bitsy-ai/printnanny-sdwire/README.md

# printnanny-sdwire
A modified version of Tizen SDWire https://wiki.tizen.org/SDWire
