bitsy-ai/printnanny-sdwire/board/exports/SDWire-v1.4-r1/README.txt

PCB Thickness: 0.8mm
Surface Finish: ENIG-RoHS

File descriptions:

SDWire-v1.4-r1.GTP Top Solder Paste
SDWire-v1.4-r1.GTO Top Silkscreen
SDWire-v1.4-r1.GTS Top Solder Mask
SDWire-v1.4-r1.GTL Top Copper
SDWire-v1.4-r1.G2L Inner 2 Copper (closest to Top)
SDWire-v1.4-r1.G3L Inner 3 Copper (closest to Bottom)
SDWire-v1.4-r1.GBL Bottom Copper
SDWire-v1.4-r1.GBS Bottom Solder Mask
SDWire-v1.4-r1.GBO Bottom Silkscreen
SDWire-v1.4-r1.GBP Bottom Solder Paste

SDWire-v1.4-r1.GKO Board outline
SDWire-v1.4-r1-NPTH.XLN Non-plated drills
SDWire-v1.4-r1-PTH.XLN Plated drills
