bitsy-ai/printnanny-sdwire/board/SDWire.kicad_pcb

## KiCad design board/SDWire.kicad_pcb (2022-09-02)

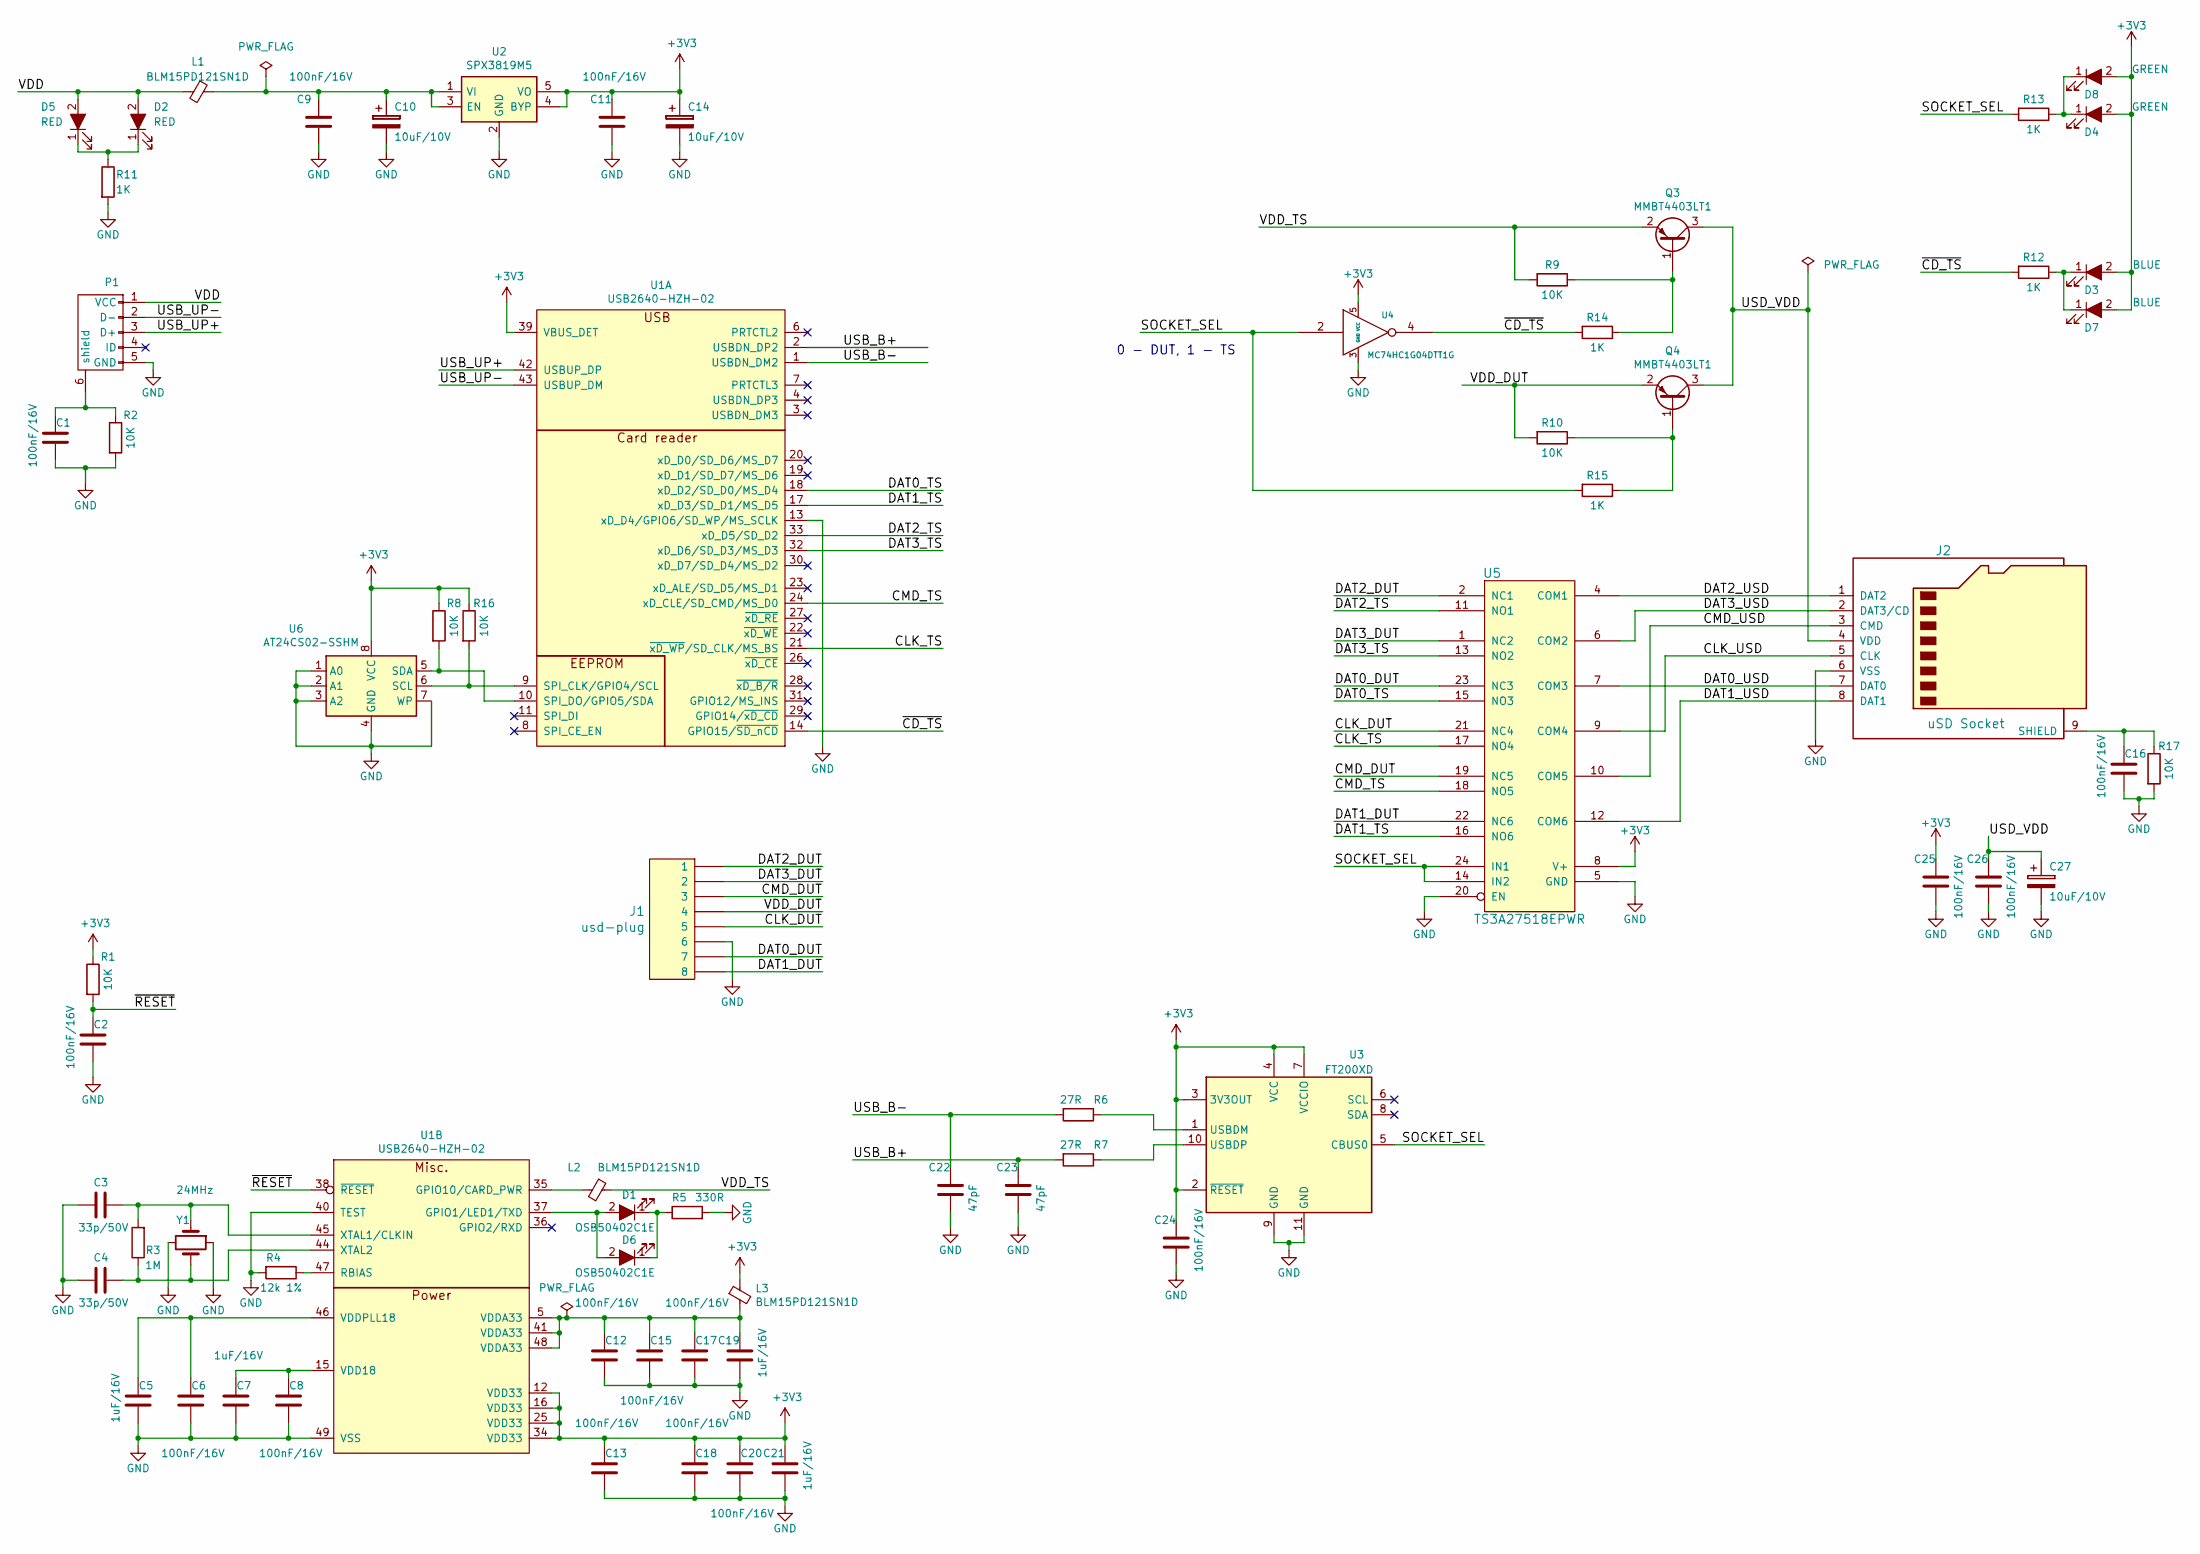
[picture p1: schematic SDWire.kicad_sch, PrintNanny SDWire]

Parts:
C1, C2, C6, C8, C9, C11, C12, C13, C15, C16, C17, C18, C20, C24, C25, C26: 100nF/16V; C_0402_1005Metric
C3, C4: 33p/50V; C_0402_1005Metric
C5, C7, C19, C21: 1uF/16V; C_0402_1005Metric
C10, C14, C27: 10uF/10V; CP_EIA-3216-18_Kemet-A_Pad1.58x1.35mm_HandSolder
C22, C23: 47pF; C_0402_1005Metric
D1, D6: OSB50402C1E; LED_0402_1005Metric
D2, D5: RED; LED_0402_1005Metric
D3, D7: BLUE; LED_0402_1005Metric
D4, D8: GREEN; LED_0402_1005Metric
J1: usd-plug; usd
J2: uSD Socket; microSD_HC_Molex_104031-0811
L1, L2, L3: BLM15PD121SN1D; L_0402_1005Metric
P1: USB_OTG_MICRO_USB; USB_Micro-B_Molex-105017-0001
Q3, Q4: MMBT4403LT1; SOT-23
R1, R2, R8, R9, R10, R16, R17: 10K; R_0402_1005Metric
R3: 1M; R_0402_1005Metric
R4: 12k 1%; R_0402_1005Metric
R5: 330R; R_0402_1005Metric
R6, R7: 27R; R_0402_1005Metric
R11, R12, R13, R14, R15: 1K; R_0402_1005Metric
U1: USB2640-HZH-02; QFN-48-1EP_7x7mm_Pitch0.5mm
U2: SPX3819M5; SOT-23-5
U3: FT200XD; DFN-10-1EP_3x3mm_P0.5mm_EP1.55x2.48mm
U4: MC74HC1G04DTT1G; SOT-23-5_HandSoldering
U5: TS3A27518EPWR; TSSOP-24
U6: AT24CS02-SSHM; SOIC-8_3.9x4.9mm_P1.27mm
Y1: 24MHz; Crystal_SMD_2520-4pin_2.5x2.0mm

Connections:
+3V3: C11.1, C13.1, C14.1, C18.1, C20.1, C21.1, C24.1, C25.1, D3.2 (A), D4.2 (A), D7.2 (A), D8.2 (A), L3.1, R1.1, R8.1, R16.1, U1.12 (VDD33), U1.16 (VDD33), U1.25 (VDD33), U1.34 (VDD33), U1.39 (VBUS_DET), U2.4 (BYP), U2.5 (VO), U3.2 (~RESET), U3.3 (3V3OUT), U3.4 (VCC), U3.7 (VCCIO), U4.5 (VCC), U5.8 (V+), U6.8 (VCC)
/CLK_DUT: J1.5, U5.21 (NC4)
/CLK_TS: U1.21 (~xD_WP/SD_CLK/MS_BS), U5.17 (NO4)
/CLK_USD: J2.5 (CLK), U5.9 (COM4)
/CMD_DUT: J1.3, U5.19 (NC5)
/CMD_TS: U1.24 (xD_CLE/SD_CMD/MS_D0), U5.18 (NO5)
/CMD_USD: J2.3 (CMD), U5.10 (COM5)
/DAT0_DUT: J1.7, U5.23 (NC3)
/DAT0_TS: U1.18 (xD_D2/SD_D0/MS_D4), U5.15 (NO3)
/DAT0_USD: J2.7 (DAT0), U5.7 (COM3)
/DAT1_DUT: J1.8, U5.22 (NC6)
/DAT1_TS: U1.17 (xD_D3/SD_D1/MS_D5), U5.16 (NO6)
/DAT1_USD: J2.8 (DAT1), U5.12 (COM6)
/DAT2_DUT: J1.1, U5.2 (NC1)
/DAT2_TS: U1.33 (xD_D5/SD_D2), U5.11 (NO1)
/DAT2_USD: J2.1 (DAT2), U5.4 (COM1)
/DAT3_DUT: J1.2, U5.1 (NC2)
/DAT3_TS: U1.32 (xD_D6/SD_D3/MS_D3), U5.13 (NO2)
/DAT3_USD: J2.2 (DAT3/CD), U5.6 (COM2)
/SOCKET_SEL: R13.2, R15.2, U3.5 (CBUS0), U4.2, U5.14 (IN2), U5.24 (IN1)
/USB_B+: C23.1, R7.2, U1.2 (USBDN_DP2)
/USB_B-: C22.1, R6.2, U1.1 (USBDN_DM2)
/USB_UP+: P1.3 (D+), U1.42 (USBUP_DP)
/USB_UP-: P1.2 (D-), U1.43 (USBUP_DM)
/USD_VDD: C26.1, C27.1, J2.4 (VDD), Q3.3 (C), Q4.3 (C)
/VDD: D2.2 (A), D5.2 (A), L1.2, P1.1 (VCC)
/VDD_DUT: J1.4, Q4.2 (E), R10.2
/VDD_TS: L2.1, Q3.2 (E), R9.2
/~CD_TS: R12.2, R14.2, U1.14 (GPIO15/~SD_nCD), U4.4
/~RESET: C2.1, R1.2, U1.38 (~RESET)
GND: C1.2, C2.2, C3.2, C4.2, C5.2, C6.2, C7.2, C8.2, C9.2, C10.2, C11.2, C12.2, C13.2, C14.2, C15.2, C16.2, C17.2, C18.2, C19.2, C20.2, C21.2, C22.2, C23.2, C24.2, C25.2, C26.2, C27.2, J1.6, J2.6 (VSS), P1.5 (GND), R2.2, R4.2, R5.2, R11.2, R17.2, U1.13 (xD_D4/GPIO6/SD_WP/MS_SCLK), U1.40 (TEST), U1.49 (VSS), U2.2 (GND), U3.9 (GND), U3.11 (GND), U4.3 (GND), U5.5 (GND), U5.20 (EN), U6.1 (A0), U6.2 (A1), U6.3 (A2), U6.4 (GND), U6.7 (WP), Y1.2, Y1.4
unnamed: C1.1, P1.6 (shield), R2.1
unnamed: C3.1, R3.2, U1.45 (XTAL1/CLKIN), Y1.1
unnamed: C4.1, R3.1, U1.44 (XTAL2), Y1.3
unnamed: C5.1, C6.1, U1.46 (VDDPLL18)
unnamed: C7.1, C8.1, U1.15 (VDD18)
unnamed: C9.1, C10.1, L1.1, U2.1 (VI), U2.3 (EN)
unnamed: C12.1, C15.1, C17.1, C19.1, L3.2, U1.5 (VDDA33), U1.41 (VDDA33), U1.48 (VDDA33)
unnamed: C16.1, J2.9 (SHIELD), R17.1
unnamed: D1.1 (K), D6.1 (K), R5.1
unnamed: D1.2 (A), D6.2 (A), U1.37 (GPIO1/LED1/TXD)
unnamed: D2.1 (K), D5.1 (K), R11.1
unnamed: D3.1 (K), D7.1 (K), R12.1
unnamed: D4.1 (K), D8.1 (K), R13.1
unnamed: L2.2, U1.35 (GPIO10/CARD_PWR)
unnamed: Q3.1 (B), R9.1, R14.1
unnamed: Q4.1 (B), R10.1, R15.1
unnamed: R4.1, U1.47 (RBIAS)
unnamed: R6.1, U3.1 (USBDM)
unnamed: R7.1, U3.10 (USBDP)
unnamed: R8.2, U1.10 (SPI_DO/GPIO5/SDA), U6.5 (SDA)
unnamed: R16.2, U1.9 (SPI_CLK/GPIO4/SCL), U6.6 (SCL)

Notes on the sheet:
0 - DUT, 1 - TS

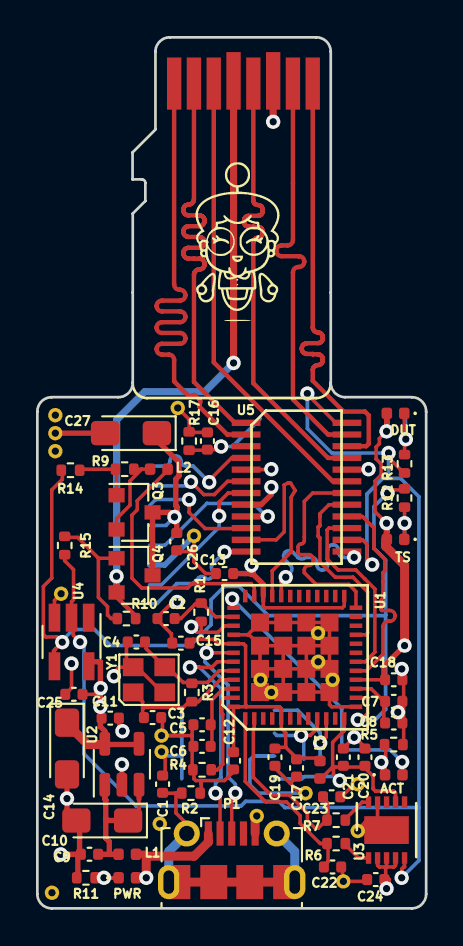
[picture p2: board SDWire.kicad_pcb from above]

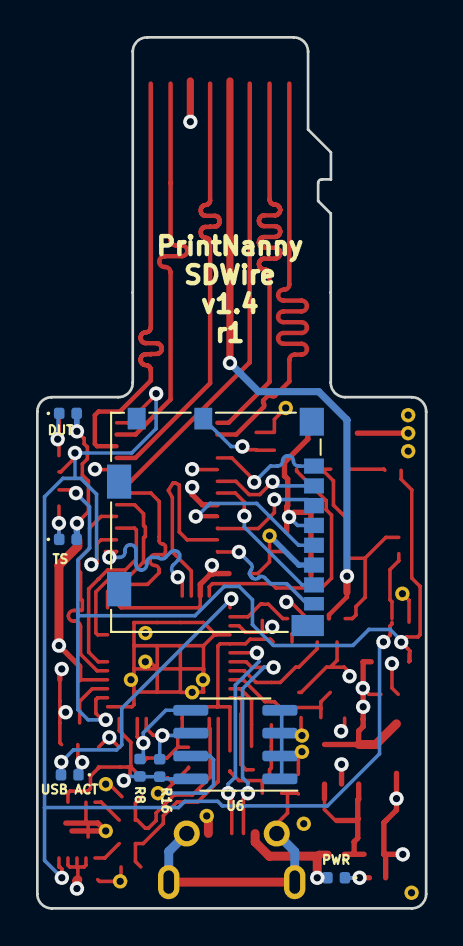
[picture p3: board SDWire.kicad_pcb from below]

Board: 4 copper layers, 21.6 x 48.4 mm, 67 parts (8 on the bottom side), 52 nets.
