bitsy-ai/printnanny-sdwire/pictures/PrintNanny-SDWire-v1.4-r1-schematic.pdf

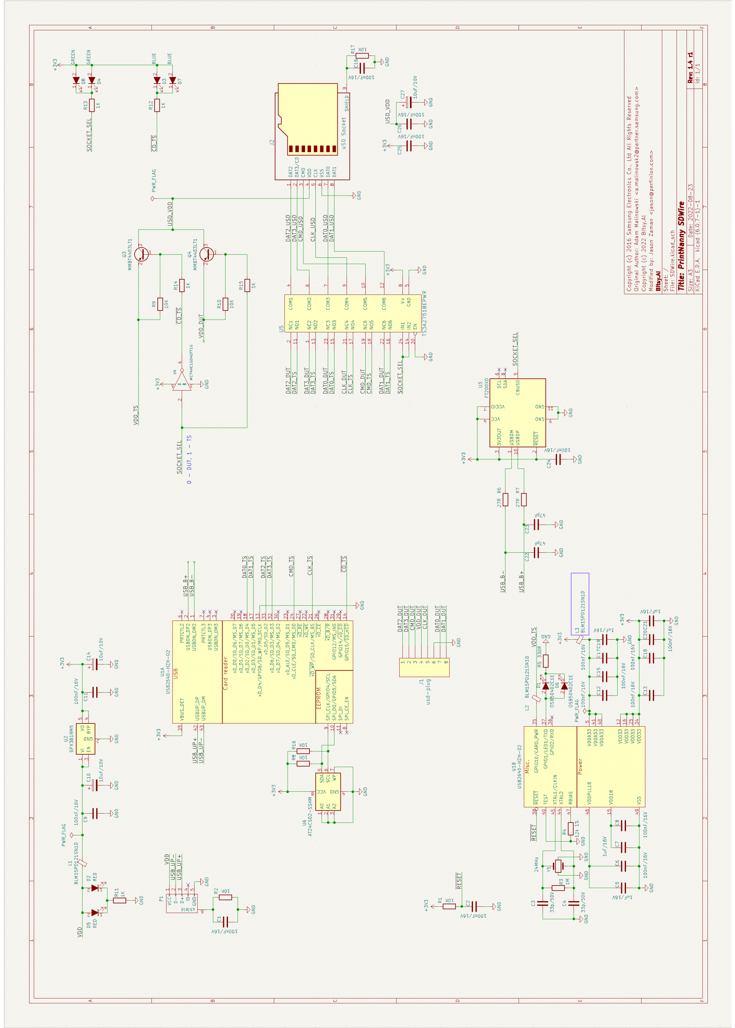
[picture p4: page 1]
