bitsy-ai/printnanny-sdwire/(threads)

Thread 1 (2022-09-02):

Document order fulfillment process

leigh-johnson, 2022-09-02:
### Stripe Checkout Session

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

## Order fulfillment

### How to: Import New Inventory

1. Assemble board <link to instructions>
2. Create a new `InventoryItem` with `type=sdwire version=<version>` per board  (Django admin panel) <screenshot>
3. Select all newly-created InventoryItem rows (Django admin panel) and click the "Download QR label" action  <screenshot>
4. Print QR label pdf <sticker sheet size> using `Brother` black/white laser printer
5. Peel stickers from the backing, affix 1 QR sticker per board <link to picture showing sticker placement>

### How to: Run Quality Control Tests

**QC one-time setup:**

- Raspberry Pi 400 w/ monitor, keyboard, IMX219 camera sensor
- USB thermal printer
- Insert `PrintNanny SDWire QC Host` SD card into Raspberry Pi 400

**Repeat for each SDWire board**

1. Click the `SDWire QC` icon on the Raspberry Pi 400's desktop
2. Scan QR code to begin test
3. Connect SDWire to Raspberry Pi 400 via USB cable
4. Connect SDWire to device-under-test (DUT) via SD card socket
5. Run the test suite
6. Click "Print + Upload Test Result"
7. Include thermal print of test results in SDWire packaging

### How to: Prepare Backordered Shipments

1. Select all orders with `status=INVENTORY_BACKORDER` and click the "Prepare for Shipment" action.  (Django admin panel)

The orders you selected should now be associated with an `InventoryItem` that has passed quality control. <screenshot>

The status of the order should be updated to `SHIPMENT_PENDING_ADDRESS_CONFIRMATION`. An email will be sent to the customer to confirm/update their shipping address (re-sent every 24 hours until confirmation is received).

If there is insufficient inventory to process all backorders, backorders will be filled in the order they were created.

2. Select all orders with `status=SHIPMENT_PENDING_CARRIER_LABEL` and click "Download shipping label" action <screenshot>
The customer will receive a "tracking info created" email when you do this.
4. Print shipping labels <sticker sheet size> using `Bother` black/white laser printer
5. Before you label and seal each box, verify the inventory number(s) on the label matches the inventory numbers on the QR code stickers <photos>
6. Place labeled/sealed boxes in outgoing mail crate
7.

Thread 4 (2022-09-02):

3D-printable case

leigh-johnson, 2022-09-02:

Petros626, 2023-02-28:
@leigh-johnson did you create one? would be awesome to bring this sensitive pcb into a protecting case

Thread 5 (2022-09-09):

Stripe checkout fails if Stripe customer already exists

leigh-johnson, 2022-09-09:
The "Checkout with Stripe" button throws an error if you click it while logged in as a user who already has a Stripe customer associated with their PrintNanny account.

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

leigh-johnson, 2022-12-17:
This is now fixed.

Closed 2022-12-17.

Thread 6 (2023-02-09):

Problem with SDWire connection

Petros626, 2023-02-09:
Hey,

I'm using the SDWIre with the  libFTDI library. The problem is, that I stuck in a step of the official SDWire usage (https://docs.dasharo.com/transparent-validation/sd-wire/usage-validation/).

Could you help me with the` Number of FTDI devices found: ` command? For this result normally you configure the SDWire with

 `sudo sd-mux-ctrl --device-serial=DB007V7V --vendor=0x0403 --product=0x6015 --device-type=sd-wire --set-serial=sd-wire_11
`
which ends up in rejcting the USB Device from my port.

Thanks
