bitsy-ai/printnanny-sdwire/(commit log)

2022-09-02 Initial commit of PrintNanny-SDWire-v1.4-r1
    [SDWire.kicad_pcb, SDWire.kicad_sch]
2022-09-02 Add SDWire-v1.4-r1 gerbers
    Closes: https://github.com/bitsy-ai/printnanny-sdwire/issues/2
    [SDWire-BOM.v1.4-r1.csv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]
2022-09-03 add PrintNanny-SDWire-v1.4-r1-schematic.pdf
2023-01-17 error LNK2019: unresolved external symbol "struct poptOption * poptHelpOptions"
    [main.cpp]
