bitsy-ai/printnanny-sdwire/(notices)

Notices in the files:
board/SDWire.kicad_pcb:
Copyright (c) 2022 Bitsy AI Labs LLC. All Rights Reserved
Copyright (c) 2016 Samsung Electronics Co., Ltd All Rights Reserved
